fsodari/USBAudioBridge/README.md

# USB Audio Bridge

KiCAD Project for a USB Audio Bridge based on an NXP RT1010

## Requirements

- NXP RT1010
- High Speed USB C connector
- MCU Link compatible SWD header
- 2 PMOD pin headers designed to mate with an Arty A7 development board
    - Route 2 I2S busses through one PMOD. One for input, one for output
    - Route SPI and GPIO through the second PMOD.
- Should be designed for a USB asynchronous audio class device.
- Should use a stable, accurate, 24.576Mhz oscillator for the Audio master clock

## KiCAD Project Requirements
- All erc/drc should pass
- Include 3D models for all parts
- Set up pipelines to generate design files that can be delivered to a PCBA manufacturer

## Using this repository

- `hardware/`: KiCad 10 project (revision v1.0). The schematic is generated from `tools/design.py`; edit that, not the `.kicad_sch` files.
- `docs/reference-manual.md`: developer reference for the RT1010 firmware and the Arty A7 FPGA design (pin map, clocks, boot, I2S/USB/SPI, XDC constraints, errata).
- Fabrication outputs for JLCPCB and PCBWay (Gerbers, drill, BOM, pick-and-place, assembly drawings, schematic PDF):
  - locally: `python3 tools/fab.py` (needs KiCad 10), output in `hardware/build/fab/`
  - on GitHub: the "Fabrication outputs" workflow runs on every push to `main` and uploads both packages as artifacts; pushing a `v*` tag attaches them to a release.
