fsodari/USBAudioBridge/hardware/USBAudioBridge.kicad_pcb

## KiCad design hardware/USBAudioBridge.kicad_pcb (2026-10-24)

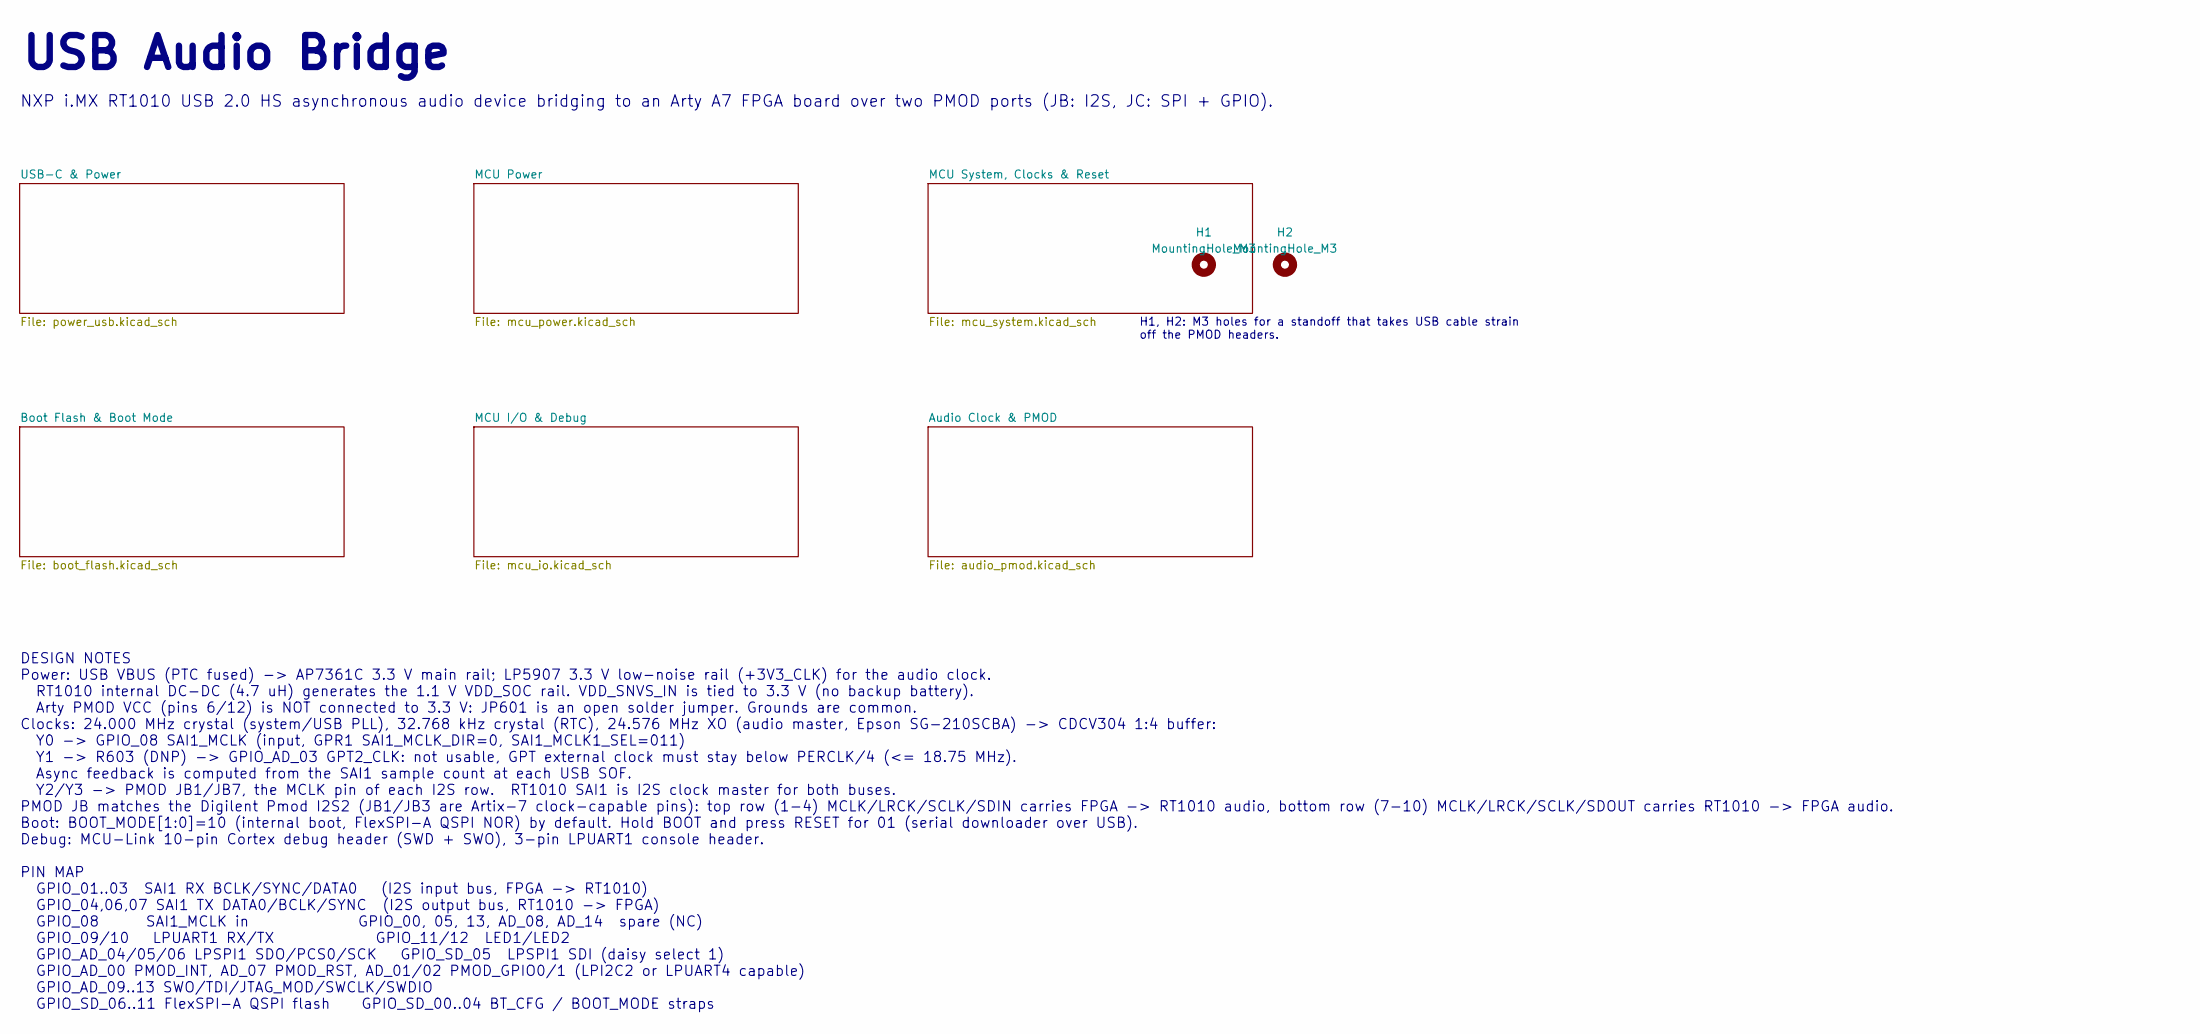
[picture p1: schematic USBAudioBridge.kicad_sch, USB Audio Bridge]

Parts:
H1, H2: MountingHole_M3; MountingHole_3.2mm_M3

Notes on the sheet:
USB Audio Bridge
DESIGN NOTES Power: USB VBUS (PTC fused) -> AP7361C 3.3 V main rail; LP5907 3.3 V low-noise rail (+3V3_CLK) for the audio clock. RT1010 internal DC-DC (4.7 uH) generates the 1.1 V VDD_SOC rail. VDD_SNVS_IN is tied to 3.3 V (no backup battery). Arty PMOD VCC (pins 6/12) is NOT connected to 3.3 V: JP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
H1, H2: M3 holes for a standoff that takes USB cable strain off the PMOD headers.
NXP i.MX RT1010 USB 2.0 HS asynchronous audio device bridging to an Arty A7 FPGA board over two PMOD ports (JB: I2S, JC: SPI + GPIO).

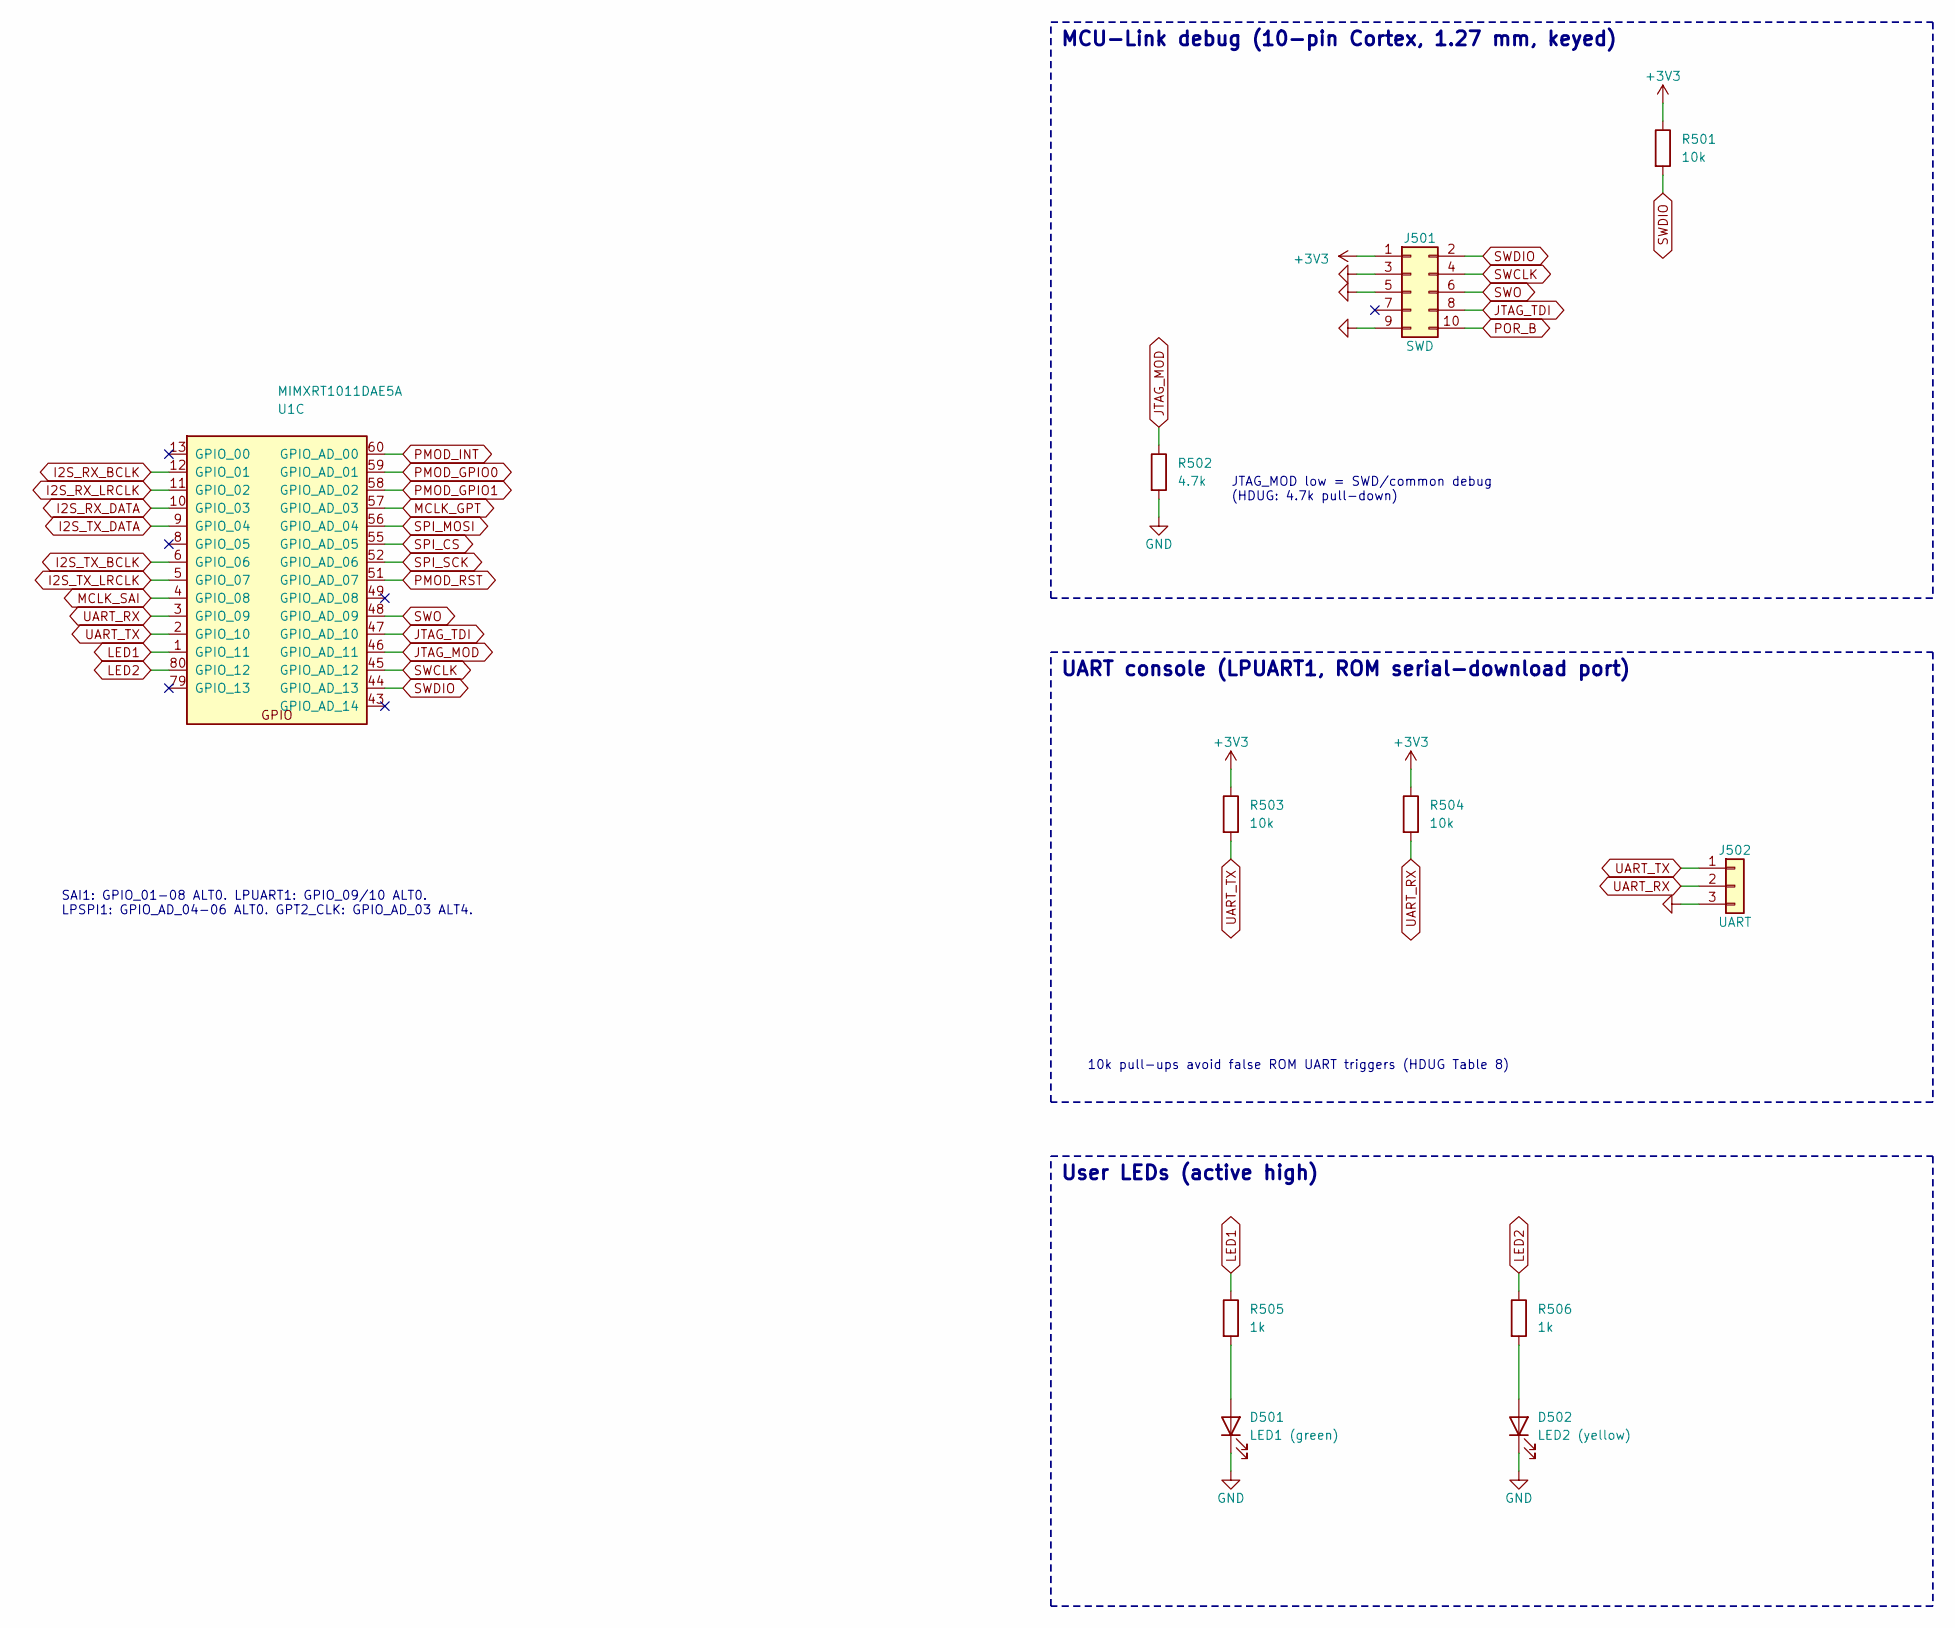
[picture p2: schematic mcu_io.kicad_sch, USB Audio Bridge]

Parts:
D501: LED1 (green); LED_0603_1608Metric; MPN KT-0603YG; LCSC C2289
D502: LED2 (yellow); LED_0603_1608Metric; MPN KT-0603Y; LCSC C2287
J501: SWD; Samtec_FTSH-105-01-L-DV-K; MPN FTSH-105-01-L-DV-K; LCSC C5155080
J502: UART; PinHeader_1x03_P2.54mm_Vertical; MPN PZ254V-11-03P; LCSC C2937625
R501, R503, R504: 10k; R_0402_1005Metric; MPN 0402WGF1002TCE; LCSC C25744
R502: 4.7k; R_0402_1005Metric; MPN 0402WGF4701TCE; LCSC C25900
R505, R506: 1k; R_0402_1005Metric; MPN 0402WGF1001TCE; LCSC C11702
U1: MIMXRT1011DAE5A; LQFP-80_12x12mm_P0.5mm; MPN MIMXRT1011DAE5A; LCSC C1575810

Connections:
+3V3: J501.1, R501.1, R503.1, R504.1; also elsewhere on the board
GND: D501.1 (K), D502.1 (K), J501.3, J501.5, J501.9, J502.3, R502.2; also elsewhere on the board
I2S_RX_BCLK: U1.12 (GPIO_01); also elsewhere on the board
I2S_RX_DATA: U1.10 (GPIO_03); also elsewhere on the board
I2S_RX_LRCLK: U1.11 (GPIO_02); also elsewhere on the board
I2S_TX_BCLK: U1.6 (GPIO_06); also elsewhere on the board
I2S_TX_DATA: U1.9 (GPIO_04); also elsewhere on the board
I2S_TX_LRCLK: U1.5 (GPIO_07); also elsewhere on the board
JTAG_MOD: R502.1, U1.46 (GPIO_AD_11)
JTAG_TDI: J501.8, U1.47 (GPIO_AD_10)
LED1: R505.1, U1.1 (GPIO_11)
LED2: R506.1, U1.80 (GPIO_12)
MCLK_GPT: U1.57 (GPIO_AD_03); also elsewhere on the board
MCLK_SAI: U1.4 (GPIO_08); also elsewhere on the board
unnamed: D501.2 (A), R505.2
unnamed: D502.2 (A), R506.2
PMOD_GPIO0: U1.59 (GPIO_AD_01); also elsewhere on the board
PMOD_GPIO1: U1.58 (GPIO_AD_02); also elsewhere on the board
PMOD_INT: U1.60 (GPIO_AD_00); also elsewhere on the board
PMOD_RST: U1.51 (GPIO_AD_07); also elsewhere on the board
POR_B: J501.10; also elsewhere on the board
SPI_CS: U1.55 (GPIO_AD_05); also elsewhere on the board
SPI_MOSI: U1.56 (GPIO_AD_04); also elsewhere on the board
SPI_SCK: U1.52 (GPIO_AD_06); also elsewhere on the board
SWCLK: J501.4, U1.45 (GPIO_AD_12)
SWDIO: J501.2, R501.2, U1.44 (GPIO_AD_13)
SWO: J501.6, U1.48 (GPIO_AD_09)
UART_RX: J502.2, R504.2, U1.3 (GPIO_09)
UART_TX: J502.1, R503.2, U1.2 (GPIO_10)

Notes on the sheet:
10k pull-ups avoid false ROM UART triggers (HDUG Table 8)
UART console (LPUART1, ROM serial-download port)
User LEDs (active high)
SAI1: GPIO_01-08 ALT0. LPUART1: GPIO_09/10 ALT0. LPSPI1: GPIO_AD_04-06 ALT0. GPT2_CLK: GPIO_AD_03 ALT4.
MCU-Link debug (10-pin Cortex, 1.27 mm, keyed)
JTAG_MOD low = SWD/common debug (HDUG: 4.7k pull-down)

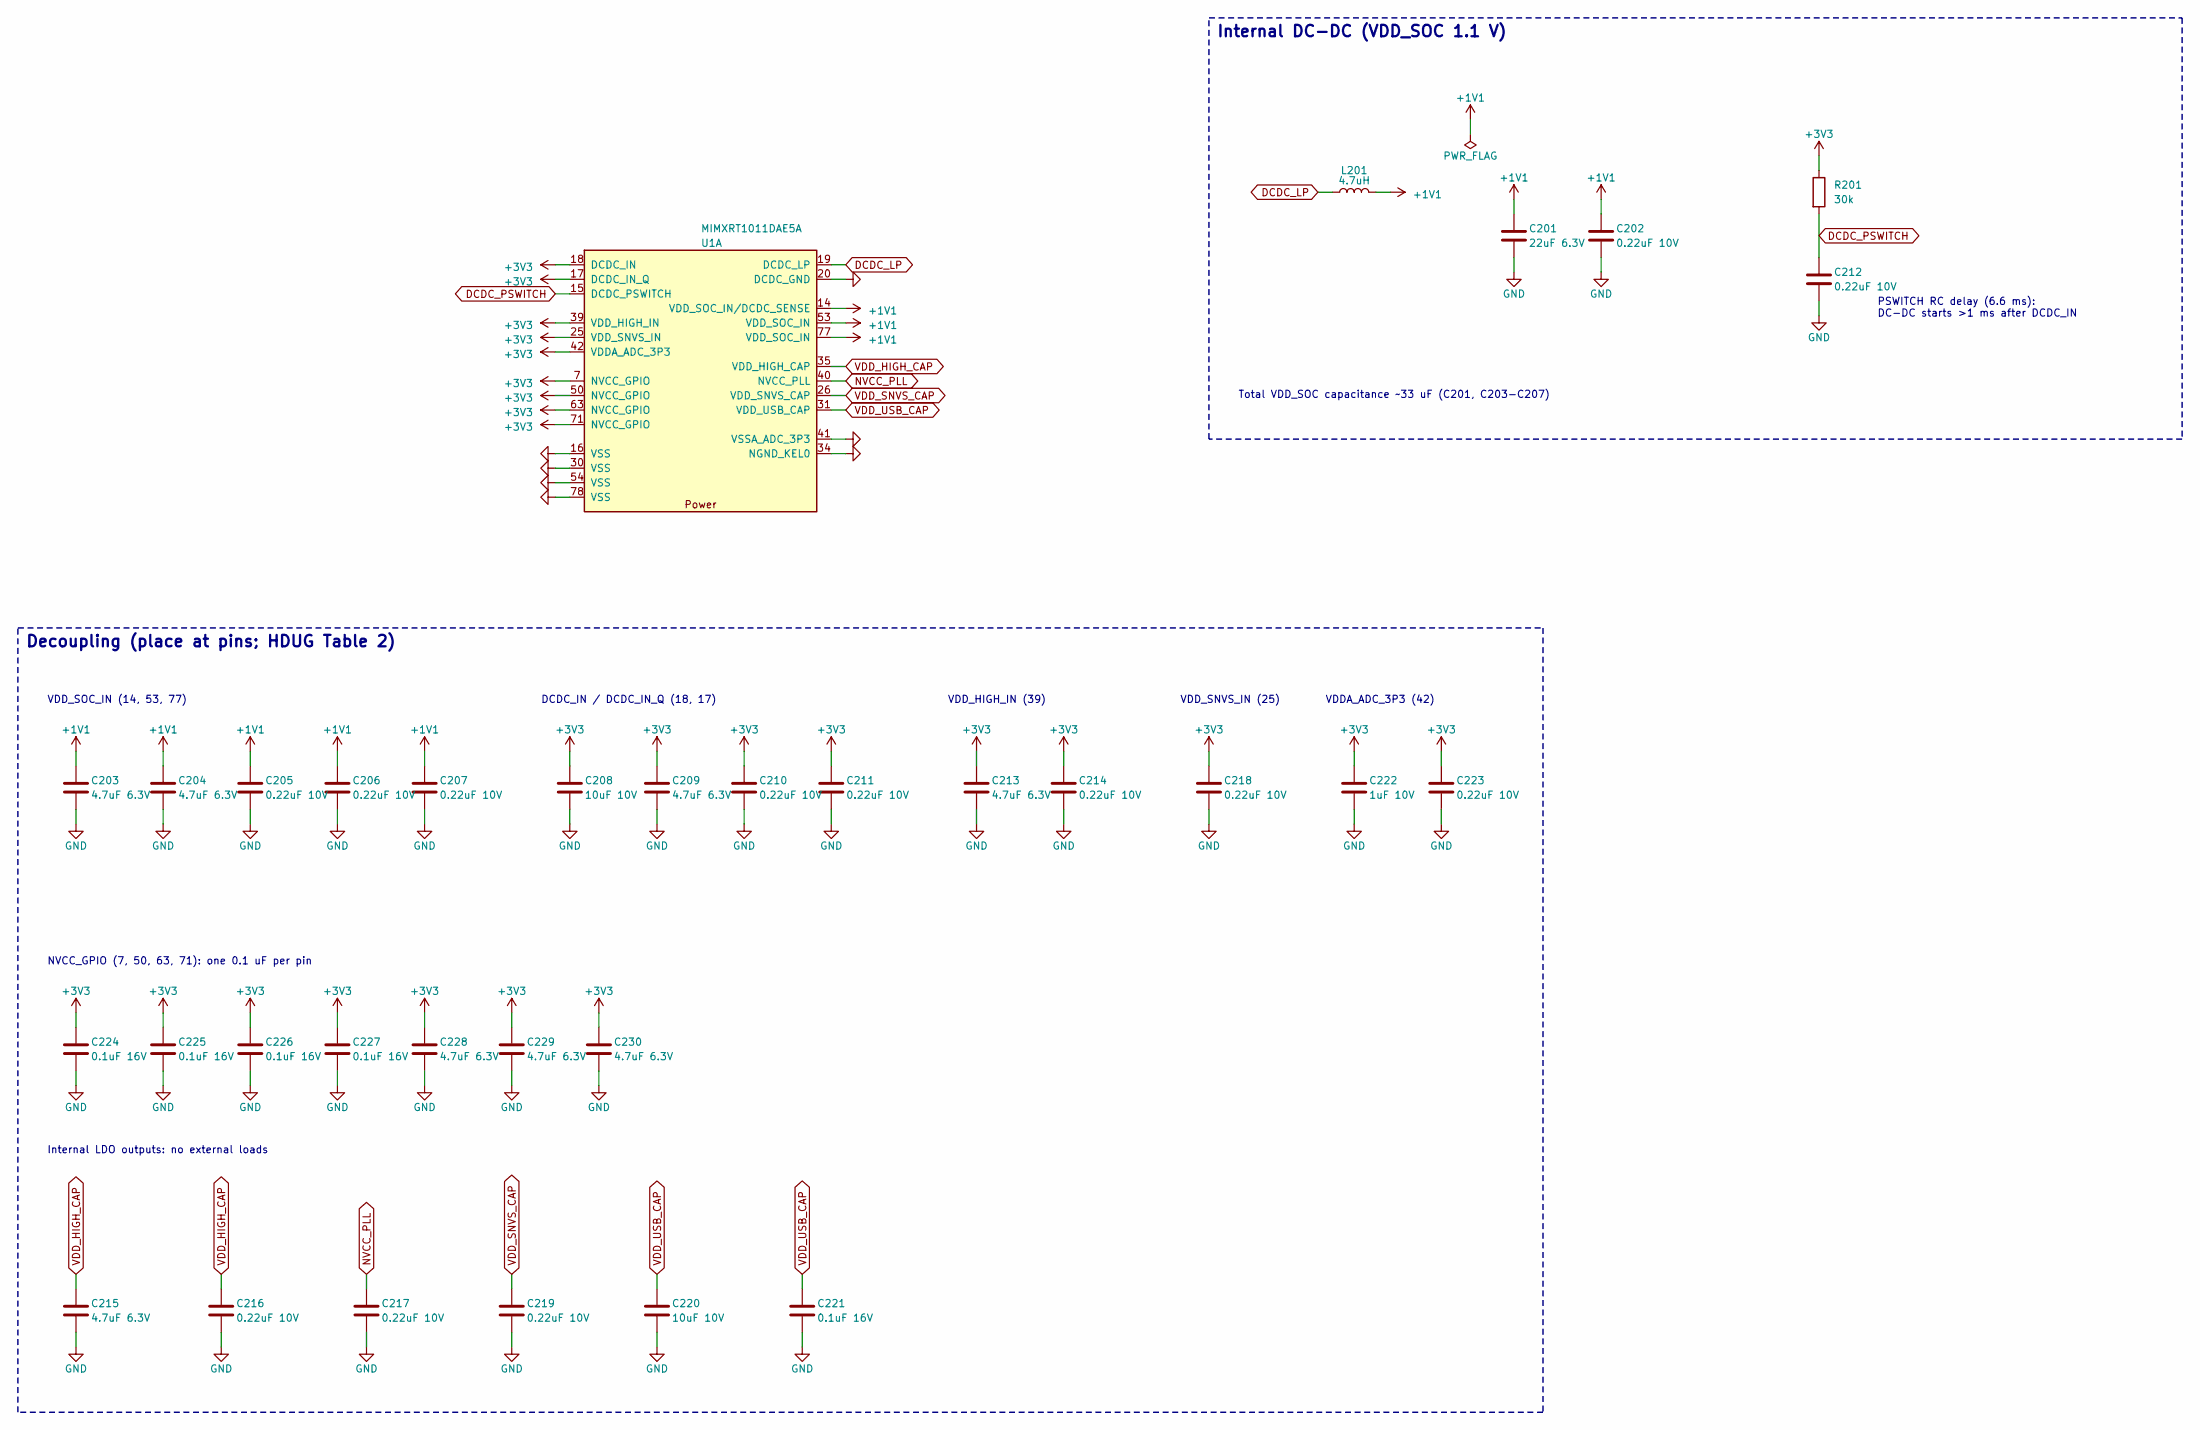
[picture p3: schematic mcu_power.kicad_sch, USB Audio Bridge]

Parts:
C201: 22uF 6.3V; C_0805_2012Metric; MPN CL21A226MAQNNNE; LCSC C45783
C202, C205, C206, C207, C210, C211, C212, C214, C216, C217, C218, C219, C223: 0.22uF 10V; C_0402_1005Metric; MPN CL05B224KO5NNNC; LCSC C16772
C203, C204, C209, C213, C215, C228, C229, C230: 4.7uF 6.3V; C_0402_1005Metric; MPN CL05A475MP5NRNC; LCSC C23733
C208, C220: 10uF 10V; C_0603_1608Metric; MPN CL10A106KP8NNNC; LCSC C19702
C221, C224, C225, C226, C227: 0.1uF 16V; C_0402_1005Metric; MPN CL05B104KO5NNNC; LCSC C1525
C222: 1uF 10V; C_0402_1005Metric; MPN CL05A105KA5NQNC; LCSC C52923
L201: 4.7uH; L_Bourns-SRN4018; MPN SRN4018-4R7M; LCSC C780206
R201: 30k; R_0402_1005Metric; MPN 0402WGF3002TCE; LCSC C25776
U1: MIMXRT1011DAE5A; LQFP-80_12x12mm_P0.5mm; MPN MIMXRT1011DAE5A; LCSC C1575810

Connections:
+1V1: C201.1, C202.1, C203.1, C204.1, C205.1, C206.1, C207.1, L201.2, U1.14 (VDD_SOC_IN/DCDC_SENSE), U1.53 (VDD_SOC_IN), U1.77 (VDD_SOC_IN)
+3V3: C208.1, C209.1, C210.1, C211.1, C213.1, C214.1, C218.1, C222.1, C223.1, C224.1, C225.1, C226.1, C227.1, C228.1, C229.1, C230.1, R201.1, U1.7 (NVCC_GPIO), U1.17 (DCDC_IN_Q), U1.18 (DCDC_IN), U1.25 (VDD_SNVS_IN), U1.39 (VDD_HIGH_IN), U1.42 (VDDA_ADC_3P3), U1.50 (NVCC_GPIO), U1.63 (NVCC_GPIO), U1.71 (NVCC_GPIO); also elsewhere on the board
DCDC_LP: L201.1, U1.19 (DCDC_LP)
DCDC_PSWITCH: C212.1, R201.2, U1.15 (DCDC_PSWITCH)
GND: C201.2, C202.2, C203.2, C204.2, C205.2, C206.2, C207.2, C208.2, C209.2, C210.2, C211.2, C212.2, C213.2, C214.2, C215.2, C216.2, C217.2, C218.2, C219.2, C220.2, C221.2, C222.2, C223.2, C224.2, C225.2, C226.2, C227.2, C228.2, C229.2, C230.2, U1.16 (VSS), U1.20 (DCDC_GND), U1.30 (VSS), U1.34 (NGND_KEL0), U1.41 (VSSA_ADC_3P3), U1.54 (VSS), U1.78 (VSS); also elsewhere on the board
NVCC_PLL: C217.1, U1.40 (NVCC_PLL)
VDD_HIGH_CAP: C215.1, C216.1, U1.35 (VDD_HIGH_CAP)
VDD_SNVS_CAP: C219.1, U1.26 (VDD_SNVS_CAP)
VDD_USB_CAP: C220.1, C221.1, U1.31 (VDD_USB_CAP)

Notes on the sheet:
Internal DC-DC (VDD_SOC 1.1 V)
Total VDD_SOC capacitance ~33 uF (C201, C203-C207)
NVCC_GPIO (7, 50, 63, 71): one 0.1 uF per pin
PSWITCH RC delay (6.6 ms): DC-DC starts >1 ms after DCDC_IN
VDD_SNVS_IN (25)
DCDC_IN / DCDC_IN_Q (18, 17)
VDD_SOC_IN (14, 53, 77)
VDD_HIGH_IN (39)
Internal LDO outputs: no external loads
Decoupling (place at pins; HDUG Table 2)
VDDA_ADC_3P3 (42)

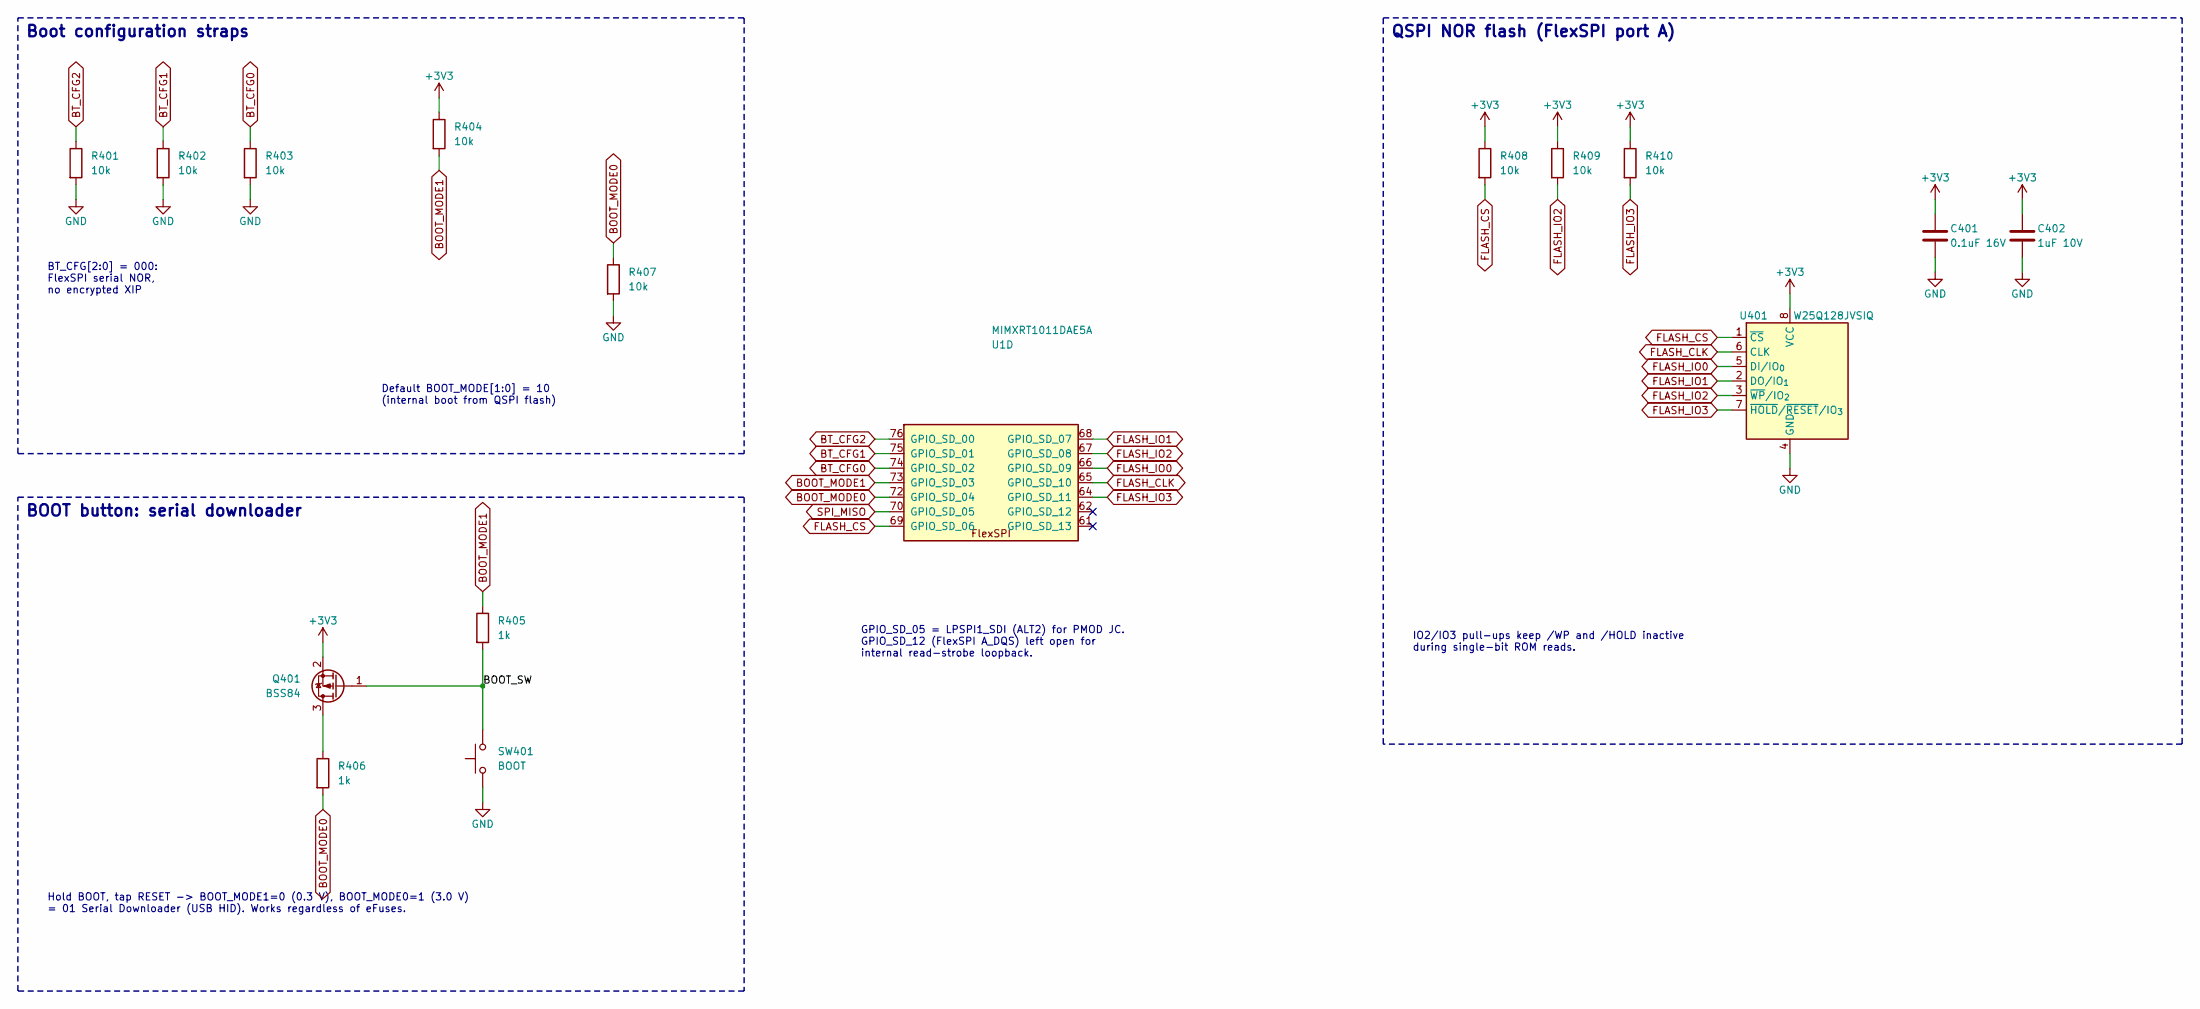
[picture p4: schematic boot_flash.kicad_sch, USB Audio Bridge]

Parts:
C401: 0.1uF 16V; C_0402_1005Metric; MPN CL05B104KO5NNNC; LCSC C1525
C402: 1uF 10V; C_0402_1005Metric; MPN CL05A105KA5NQNC; LCSC C52923
Q401: BSS84; SOT-23; MPN BSS84LT1G; LCSC C82079
R401, R402, R403, R404, R407, R408, R409, R410: 10k; R_0402_1005Metric; MPN 0402WGF1002TCE; LCSC C25744
R405, R406: 1k; R_0402_1005Metric; MPN 0402WGF1001TCE; LCSC C11702
SW401: BOOT; SW_SPST_PTS810; MPN PTS810SJG250SMTRLFS; LCSC C221895
U1: MIMXRT1011DAE5A; LQFP-80_12x12mm_P0.5mm; MPN MIMXRT1011DAE5A; LCSC C1575810
U401: W25Q128JVSIQ; SOIC-8_5.3x5.3mm_P1.27mm; MPN W25Q128JVSIQ; LCSC C97521

Connections:
+3V3: C401.1, C402.1, Q401.2 (S), R404.1, R408.1, R409.1, R410.1, U401.8 (VCC); also elsewhere on the board
/Boot Flash & Boot Mode/BOOT_SW: Q401.1 (G), R405.2, SW401.2
BOOT_MODE0: R406.2, R407.1, U1.72 (GPIO_SD_04)
BOOT_MODE1: R404.2, R405.1, U1.73 (GPIO_SD_03)
BT_CFG0: R403.1, U1.74 (GPIO_SD_02)
BT_CFG1: R402.1, U1.75 (GPIO_SD_01)
BT_CFG2: R401.1, U1.76 (GPIO_SD_00)
FLASH_CLK: U1.65 (GPIO_SD_10), U401.6 (CLK)
FLASH_CS: R408.2, U1.69 (GPIO_SD_06), U401.1 (~CS)
FLASH_IO0: U1.66 (GPIO_SD_09), U401.5 (DI/IO_{0})
FLASH_IO1: U1.68 (GPIO_SD_07), U401.2 (DO/IO_{1})
FLASH_IO2: R409.2, U1.67 (GPIO_SD_08), U401.3 (~WP/IO_{2})
FLASH_IO3: R410.2, U1.64 (GPIO_SD_11), U401.7 (~HOLD/~RESET/IO_{3})
GND: C401.2, C402.2, R401.2, R402.2, R403.2, R407.2, SW401.1, U401.4 (GND); also elsewhere on the board
unnamed: Q401.3 (D), R406.1
SPI_MISO: U1.70 (GPIO_SD_05); also elsewhere on the board

Notes on the sheet:
BT_CFG[2:0] = 000: FlexSPI serial NOR, no encrypted XIP
GPIO_SD_05 = LPSPI1_SDI (ALT2) for PMOD JC. GPIO_SD_12 (FlexSPI A_DQS) left open for internal read-strobe loopback.
QSPI NOR flash (FlexSPI port A)
Boot configuration straps
Default BOOT_MODE[1:0] = 10 (internal boot from QSPI flash)
BOOT button: serial downloader
IO2/IO3 pull-ups keep /WP and /HOLD inactive during single-bit ROM reads.
Hold BOOT, tap RESET -> BOOT_MODE1=0 (0.3 V), BOOT_MODE0=1 (3.0 V) = 01 Serial Downloader (USB HID). Works regardless of eFuses.

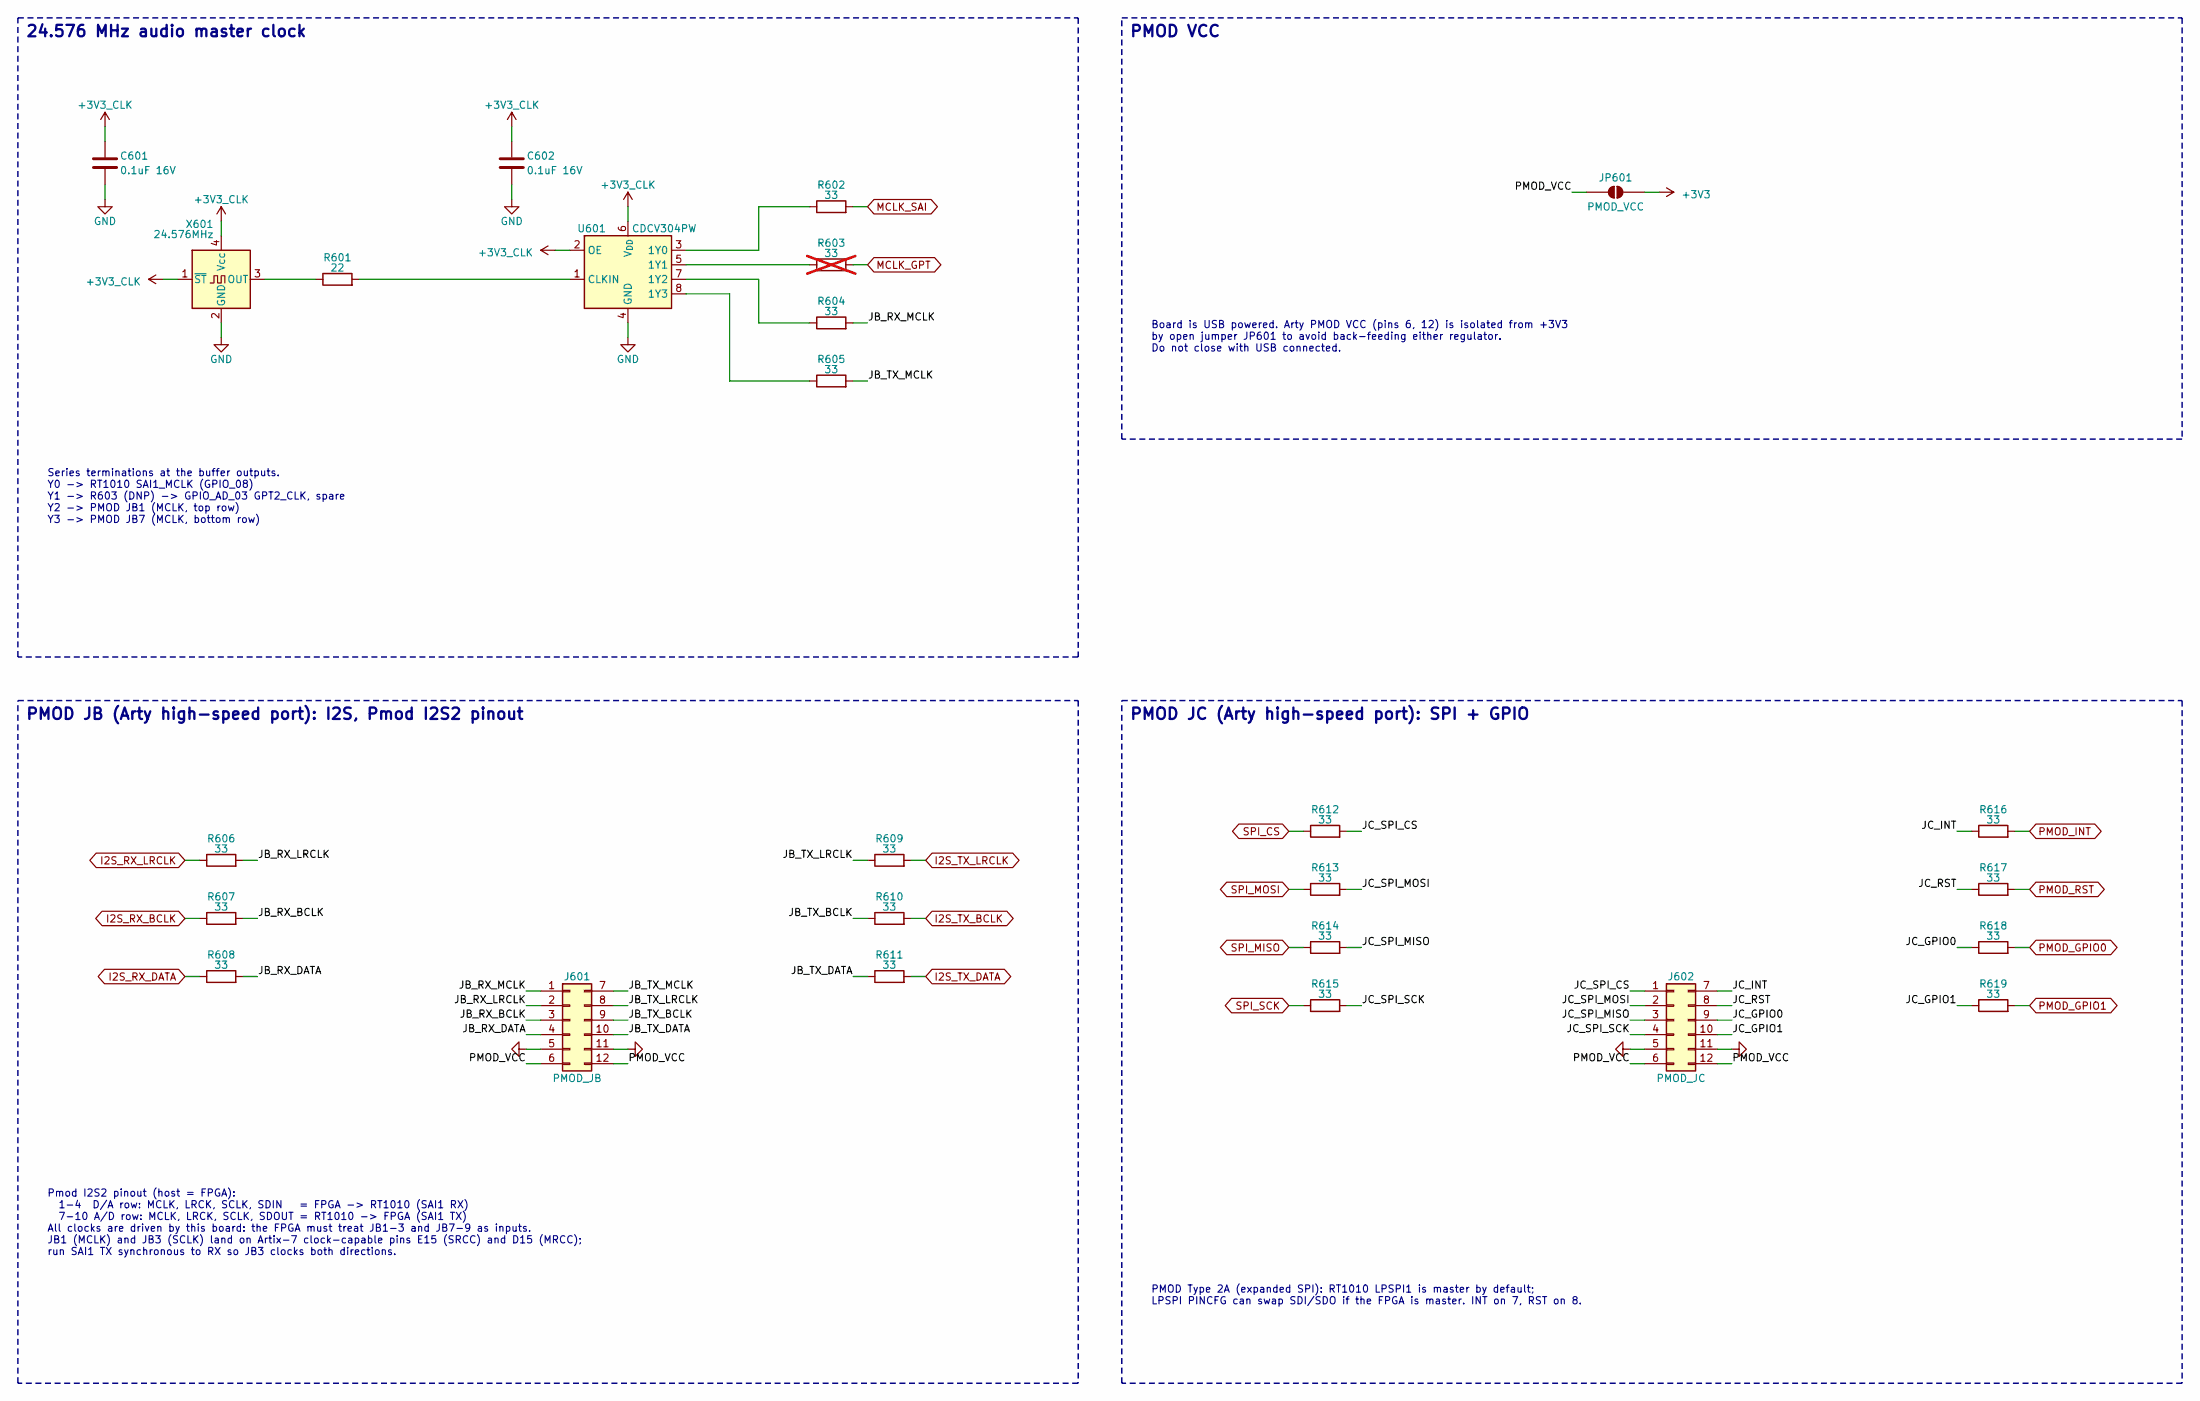
[picture p5: schematic audio_pmod.kicad_sch, USB Audio Bridge]

Parts:
C601, C602: 0.1uF 16V; C_0402_1005Metric; MPN CL05B104KO5NNNC; LCSC C1525
J601: PMOD_JB; PMOD_Peripheral_2x06_P2.54mm_Horizontal; MPN PZ254R-12-12P; LCSC C492434
J602: PMOD_JC; PMOD_Peripheral_2x06_P2.54mm_Horizontal; MPN PZ254R-12-12P; LCSC C492434
JP601: PMOD_VCC; SolderJumper-2_P1.3mm_Open_RoundedPad1.0x1.5mm
R601: 22; R_0402_1005Metric; MPN 0402WGF220JTCE; LCSC C25092
R602, R604, R605, R606, R607, R608, R609, R610, R611, R612, R613, R614, R615, R616, R617, R618, R619: 33; R_0402_1005Metric; MPN 0402WGF330JTCE; LCSC C25105
R603: 33; R_0402_1005Metric; MPN 0402WGF330JTCE; LCSC C25105; not fitted
U601: CDCV304PW; TSSOP-8_4.4x3mm_P0.65mm; MPN CDCV304PWR; LCSC C105237
X601: 24.576MHz; Oscillator_SMD_SeikoEpson_SG210-4Pin_2.5x2.0mm; MPN X1G004591A052; LCSC C5154204

Connections:
+3V3: JP601.2 (B); also elsewhere on the board
+3V3_CLK: C601.1, C602.1, U601.2 (OE), U601.6 (V_{DD}), X601.1 (~ST), X601.4 (Vcc); also elsewhere on the board
/Audio Clock & PMOD/JB_RX_BCLK: J601.3, R607.2
/Audio Clock & PMOD/JB_RX_DATA: J601.4, R608.2
/Audio Clock & PMOD/JB_RX_LRCLK: J601.2, R606.2
/Audio Clock & PMOD/JB_RX_MCLK: J601.1, R604.2
/Audio Clock & PMOD/JB_TX_BCLK: J601.9, R610.1
/Audio Clock & PMOD/JB_TX_DATA: J601.10, R611.1
/Audio Clock & PMOD/JB_TX_LRCLK: J601.8, R609.1
/Audio Clock & PMOD/JB_TX_MCLK: J601.7, R605.2
/Audio Clock & PMOD/JC_GPIO0: J602.9, R618.1
/Audio Clock & PMOD/JC_GPIO1: J602.10, R619.1
/Audio Clock & PMOD/JC_INT: J602.7, R616.1
/Audio Clock & PMOD/JC_RST: J602.8, R617.1
/Audio Clock & PMOD/JC_SPI_CS: J602.1, R612.2
/Audio Clock & PMOD/JC_SPI_MISO: J602.3, R614.2
/Audio Clock & PMOD/JC_SPI_MOSI: J602.2, R613.2
/Audio Clock & PMOD/JC_SPI_SCK: J602.4, R615.2
/Audio Clock & PMOD/PMOD_VCC: J601.6, J601.12, J602.6, J602.12, JP601.1 (A)
GND: C601.2, C602.2, J601.5, J601.11, J602.5, J602.11, U601.4 (GND), X601.2 (GND); also elsewhere on the board
I2S_RX_BCLK: R607.1; also elsewhere on the board
I2S_RX_DATA: R608.1; also elsewhere on the board
I2S_RX_LRCLK: R606.1; also elsewhere on the board
I2S_TX_BCLK: R610.2; also elsewhere on the board
I2S_TX_DATA: R611.2; also elsewhere on the board
I2S_TX_LRCLK: R609.2; also elsewhere on the board
MCLK_GPT: R603.2; also elsewhere on the board
MCLK_SAI: R602.2; also elsewhere on the board
unnamed: R602.1, U601.3 (1Y0)
unnamed: R603.1, U601.5 (1Y1)
unnamed: R604.1, U601.7 (1Y2)
unnamed: R605.1, U601.8 (1Y3)
unnamed: R601.2, U601.1 (CLKIN)
unnamed: R601.1, X601.3 (OUT)
PMOD_GPIO0: R618.2; also elsewhere on the board
PMOD_GPIO1: R619.2; also elsewhere on the board
PMOD_INT: R616.2; also elsewhere on the board
PMOD_RST: R617.2; also elsewhere on the board
SPI_CS: R612.1; also elsewhere on the board
SPI_MISO: R614.1; also elsewhere on the board
SPI_MOSI: R613.1; also elsewhere on the board
SPI_SCK: R615.1; also elsewhere on the board

Notes on the sheet:
24.576 MHz audio master clock
PMOD JC (Arty high-speed port): SPI + GPIO
PMOD JB (Arty high-speed port): I2S, Pmod I2S2 pinout
Board is USB powered. Arty PMOD VCC (pins 6, 12) is isolated from +3V3 by open jumper JP601 to avoid back-feeding either regulator. Do not close with USB connected.
Pmod I2S2 pinout (host = FPGA): 1-4 D/A row: MCLK, LRCK, SCLK, SDIN = FPGA -> RT1010 (SAI1 RX) 7-10 A/D row: MCLK, LRCK, SCLK, SDOUT = RT1010 -> FPGA (SAI1 TX) All clocks are driven by this board: the FPGA must treat JB1-3 and JB7-9 as inputs. JB1 (MCLK) and JB3 (SCLK) land on Artix-7 clock-capable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
PMOD Type 2A (expanded SPI): RT1010 LPSPI1 is master by default; LPSPI PINCFG can swap SDI/SDO if the FPGA is master. INT on 7, RST on 8.
Series terminations at the buffer outputs. Y0 -> RT1010 SAI1_MCLK (GPIO_08) Y1 -> R603 (DNP) -> GPIO_AD_03 GPT2_CLK, spare Y2 -> PMOD JB1 (MCLK, top row) Y3 -> PMOD JB7 (MCLK, bottom row)
PMOD VCC
