fsodari/USBAudioBridge/hardware/USBAudioBridge.kicad_pcb

## KiCad design hardware/USBAudioBridge.kicad_pcb (continued)

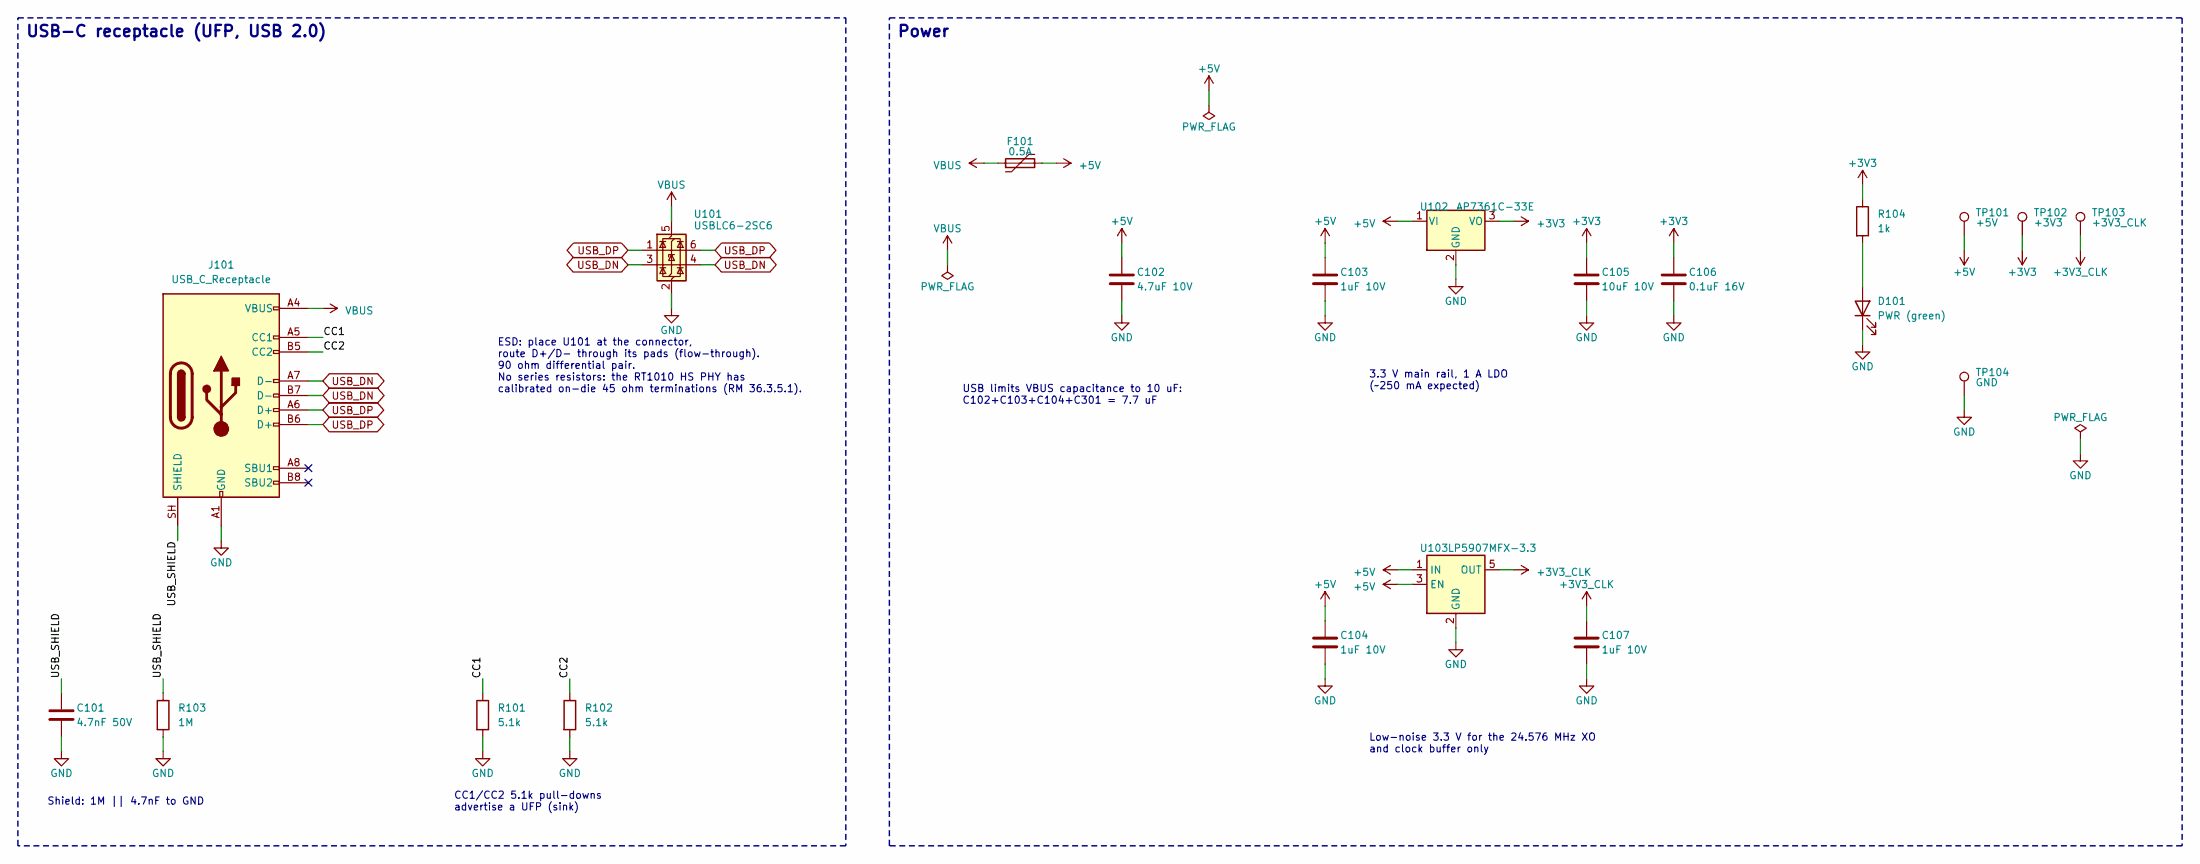
[picture p6: schematic power_usb.kicad_sch, USB Audio Bridge]

Parts:
C101: 4.7nF 50V; C_0402_1005Metric; MPN 0402B472K500NT; LCSC C1538
C102: 4.7uF 10V; C_0603_1608Metric; MPN CL10A475KO8NNNC; LCSC C19666
C103, C104, C107: 1uF 10V; C_0603_1608Metric; MPN CL10A105KB8NNNC; LCSC C15849
C105: 10uF 10V; C_0603_1608Metric; MPN CL10A106KP8NNNC; LCSC C19702
C106: 0.1uF 16V; C_0402_1005Metric; MPN CL05B104KO5NNNC; LCSC C1525
D101: PWR (green); LED_0603_1608Metric; MPN KT-0603YG; LCSC C2289
F101: 0.5A; Fuse_1206_3216Metric; MPN SMD1206P050TF/13.2; LCSC C43379
J101: USB_C_Receptacle; USB_C_Receptacle_GCT_USB4105-xx-A_16P_TopMnt_Horizontal; MPN USB4105-GF-A-120; LCSC C5184243
R101, R102: 5.1k; R_0402_1005Metric; MPN 0402WGF5101TCE; LCSC C25905
R103: 1M; R_0402_1005Metric; MPN 0402WGF1004TCE; LCSC C26083
R104: 1k; R_0402_1005Metric; MPN 0402WGF1001TCE; LCSC C11702
TP101: +5V; TestPoint_Pad_D1.0mm
TP102: +3V3; TestPoint_Pad_D1.0mm
TP103: +3V3_CLK; TestPoint_Pad_D1.0mm
TP104: GND; TestPoint_Pad_D1.0mm
U101: USBLC6-2SC6; SOT-23-6; MPN USBLC6-2SC6; LCSC C7519
U102: AP7361C-33E; SOT-223-3_TabPin2; MPN AP7361C-33E-13; LCSC C500795
U103: LP5907MFX-3.3; SOT-23-5; MPN LP5907MFX-3.3/NOPB; LCSC C80670

Connections:
+3V3: C105.1, C106.1, R104.1, TP102.1, U102.3 (VO); also elsewhere on the board
+3V3_CLK: C107.1, TP103.1, U103.5 (OUT); also elsewhere on the board
+5V: C102.1, C103.1, C104.1, F101.2, TP101.1, U102.1 (VI), U103.1 (IN), U103.3 (EN); also elsewhere on the board
/USB-C & Power/CC1: J101.A5 (CC1), R101.1
/USB-C & Power/CC2: J101.B5 (CC2), R102.1
/USB-C & Power/USB_SHIELD: C101.1, J101.SH (SHIELD), R103.1
GND: C101.2, C102.2, C103.2, C104.2, C105.2, C106.2, C107.2, D101.1 (K), J101.A1 (GND), J101.A12 (GND), J101.B1 (GND), J101.B12 (GND), R101.2, R102.2, R103.2, TP104.1, U101.2 (GND), U102.2 (GND), U103.2 (GND); also elsewhere on the board
unnamed: D101.2 (A), R104.2
USB_DN: J101.A7 (D-), J101.B7 (D-), U101.3 (I/O2), U101.4 (I/O2); also elsewhere on the board
USB_DP: J101.A6 (D+), J101.B6 (D+), U101.1 (I/O1), U101.6 (I/O1); also elsewhere on the board
VBUS: F101.1, J101.A4 (VBUS), J101.A9 (VBUS), J101.B4 (VBUS), J101.B9 (VBUS), U101.5 (VBUS)

Notes on the sheet:
Low-noise 3.3 V for the 24.576 MHz XO and clock buffer only
CC1/CC2 5.1k pull-downs advertise a UFP (sink)
USB-C receptacle (UFP, USB 2.0)
Power
Shield: 1M || 4.7nF to GND
3.3 V main rail, 1 A LDO (~250 mA expected)
USB limits VBUS capacitance to 10 uF: C102+C103+C104+C301 = 7.7 uF
ESD: place U101 at the connector, route D+/D- through its pads (flow-through). 90 ohm differential pair. No series resistors: the RT1010 HS PHY has calibrated on-die 45 ohm terminations (RM 36.3.5.1).

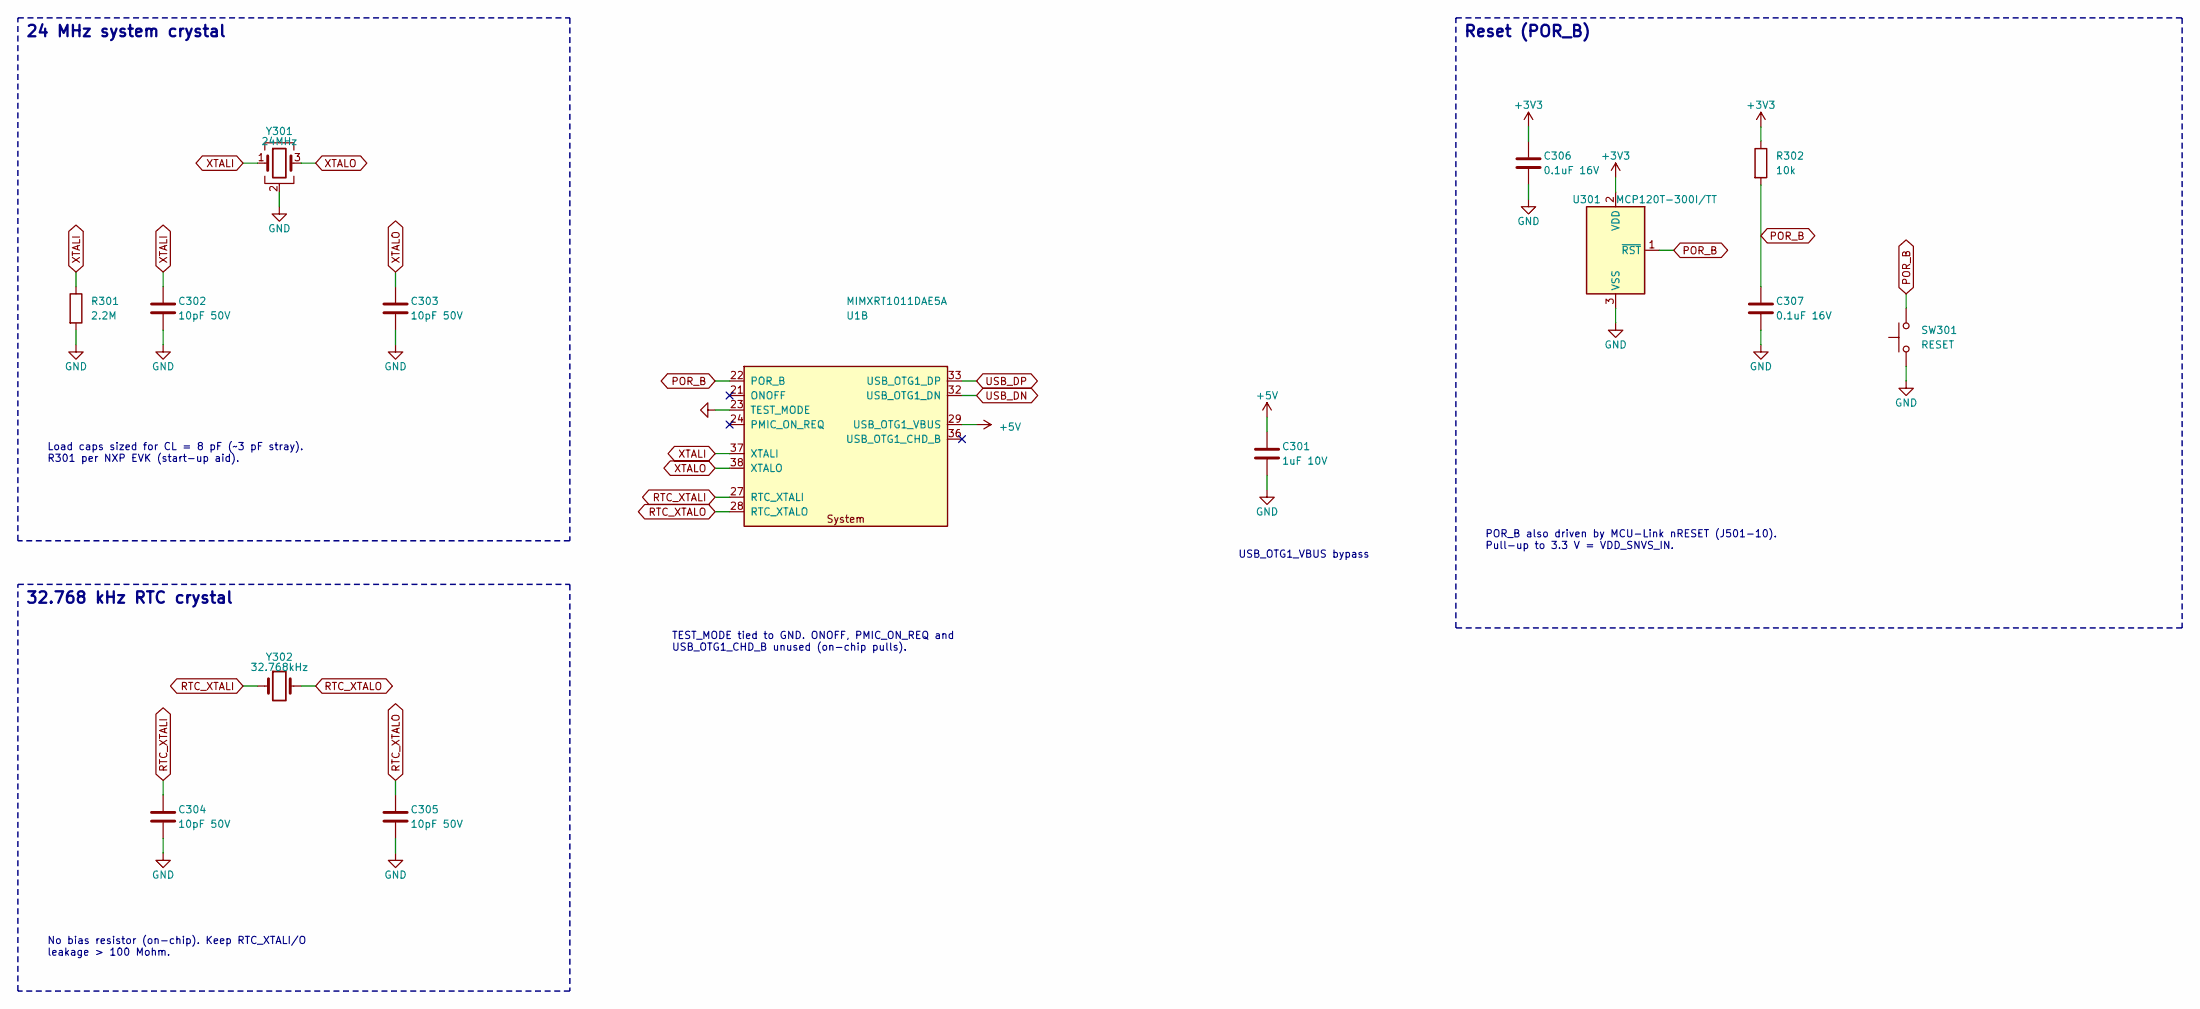
[picture p7: schematic mcu_system.kicad_sch, USB Audio Bridge]

Parts:
C301: 1uF 10V; C_0603_1608Metric; MPN CL10A105KB8NNNC; LCSC C15849
C302, C303, C304, C305: 10pF 50V; C_0402_1005Metric; MPN CL05C100JB5NNNC; LCSC C32949
C306, C307: 0.1uF 16V; C_0402_1005Metric; MPN CL05B104KO5NNNC; LCSC C1525
R301: 2.2M; R_0402_1005Metric; MPN 0402WGF2204TCE; LCSC C11490
R302: 10k; R_0402_1005Metric; MPN 0402WGF1002TCE; LCSC C25744
SW301: RESET; SW_SPST_PTS810; MPN PTS810SJG250SMTRLFS; LCSC C221895
U1: MIMXRT1011DAE5A; LQFP-80_12x12mm_P0.5mm; MPN MIMXRT1011DAE5A; LCSC C1575810
U301: MCP120T-300I/TT; SOT-23; MPN MCP120T-300I/TT; LCSC C625180
Y301: 24MHz; Crystal_SMD_3225-4Pin_3.2x2.5mm; MPN 3225-24-8-10-10/A; LCSC C2981672
Y302: 32.768kHz; Crystal_SMD_3215-2Pin_3.2x1.5mm; MPN Q13FC13500002; LCSC C48615

Connections:
+3V3: C306.1, R302.1, U301.2 (VDD); also elsewhere on the board
+5V: C301.1, U1.29 (USB_OTG1_VBUS); also elsewhere on the board
GND: C301.2, C302.2, C303.2, C304.2, C305.2, C306.2, C307.2, R301.2, SW301.1, U1.23 (TEST_MODE), U301.3 (VSS), Y301.2 (G), Y301.4 (G); also elsewhere on the board
POR_B: C307.1, R302.2, SW301.2, U1.22 (POR_B), U301.1 (~RST); also elsewhere on the board
RTC_XTALI: C304.1, U1.27 (RTC_XTALI), Y302.1
RTC_XTALO: C305.1, U1.28 (RTC_XTALO), Y302.2
USB_DN: U1.32 (USB_OTG1_DN); also elsewhere on the board
USB_DP: U1.33 (USB_OTG1_DP); also elsewhere on the board
XTALI: C302.1, R301.1, U1.37 (XTALI), Y301.1
XTALO: C303.1, U1.38 (XTALO), Y301.3

Notes on the sheet:
POR_B also driven by MCU-Link nRESET (J501-10). Pull-up to 3.3 V = VDD_SNVS_IN.
24 MHz system crystal
TEST_MODE tied to GND. ONOFF, PMIC_ON_REQ and USB_OTG1_CHD_B unused (on-chip pulls).
USB_OTG1_VBUS bypass
32.768 kHz RTC crystal
Reset (POR_B)
No bias resistor (on-chip). Keep RTC_XTALI/O leakage > 100 Mohm.
Load caps sized for CL = 8 pF (~3 pF stray). R301 per NXP EVK (start-up aid).

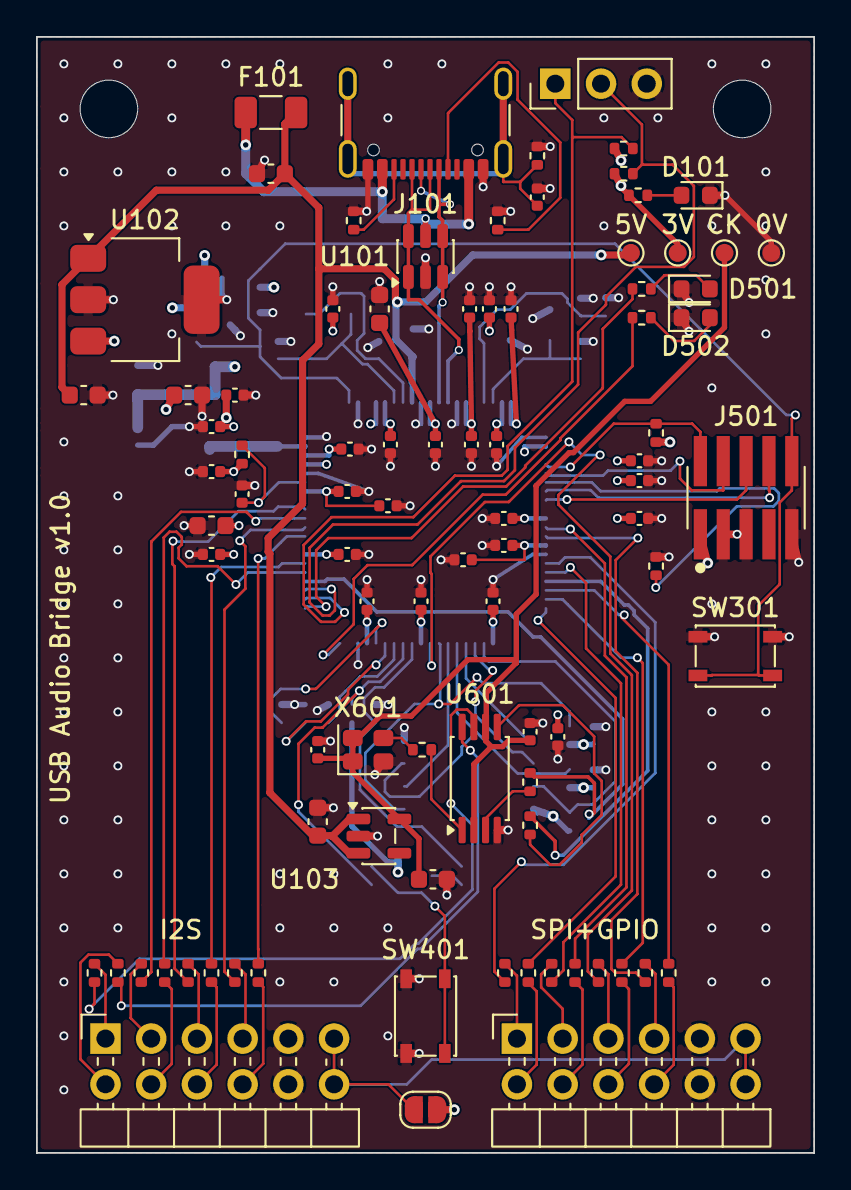
[picture p8: board USBAudioBridge.kicad_pcb from above]

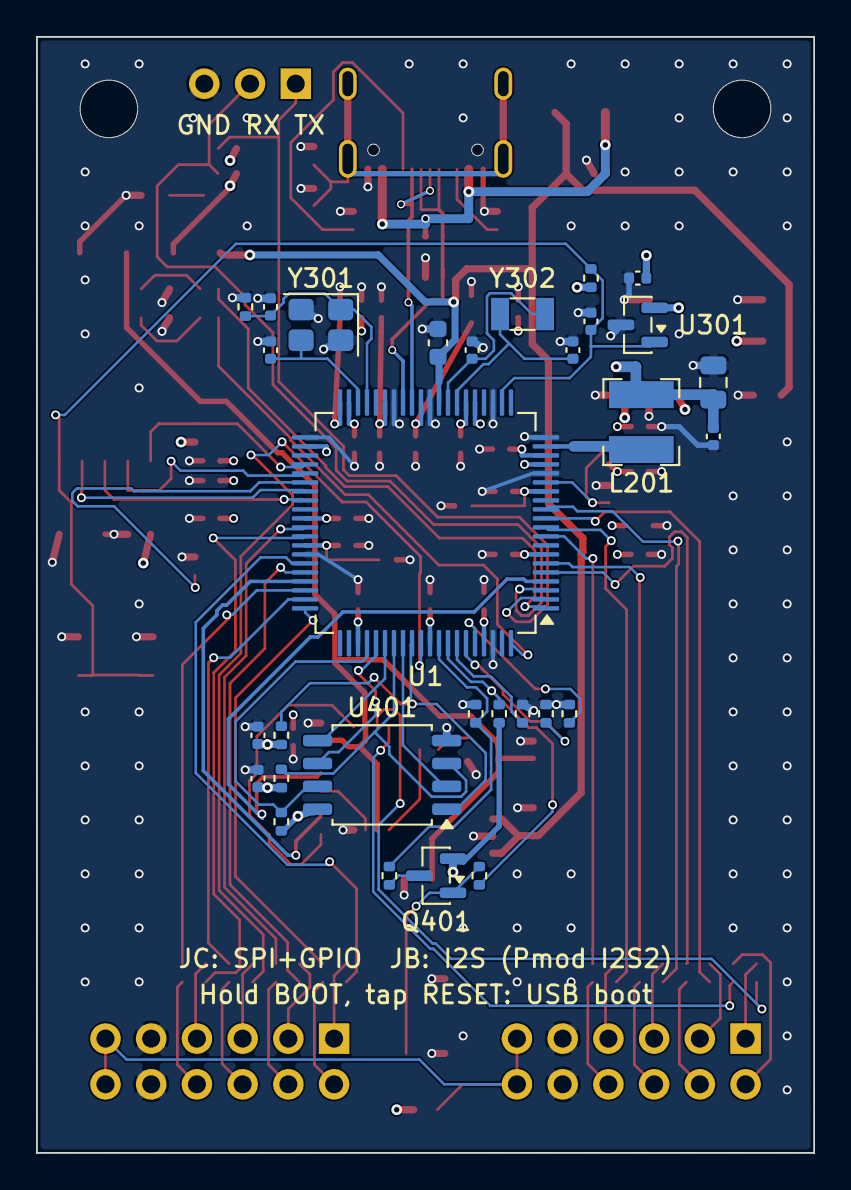
[picture p9: board USBAudioBridge.kicad_pcb from below]

Board: 4 copper layers, 43.2 x 62.0 mm, 120 parts (30 on the bottom side), 86 nets.
