fsodari/USBAudioBridge/(commit log)

2026-10-23 Step 1. Finished initial schematic layout. Pending review
    [USBAudioBridge.kicad_sch, audio_pmod.kicad_sch, boot_flash.kicad_sch, mcu_io.kicad_sch, mcu_power.kicad_sch, mcu_system.kicad_sch, power_usb.kicad_sch]
2026-10-23 Post first draft design review complete
    [USBAudioBridge.kicad_sch, audio_pmod.kicad_sch, boot_flash.kicad_sch, mcu_io.kicad_sch, mcu_power.kicad_sch, mcu_system.kicad_sch, power_usb.kicad_sch]
2026-10-23 finished pcb layout. reviewing
    [USBAudioBridge.kicad_pcb, USBAudioBridge.kicad_sch, audio_pmod.kicad_sch, boot_flash.kicad_sch, mcu_io.kicad_sch, mcu_power.kicad_sch, mcu_system.kicad_sch, power_usb.kicad_sch]
2026-10-24 post pcb layout design review
    [USBAudioBridge.kicad_sch, audio_pmod.kicad_sch, boot_flash.kicad_sch, mcu_io.kicad_sch, mcu_power.kicad_sch, mcu_system.kicad_sch]
2026-10-24 finish second pcb layout revision
    [USBAudioBridge.kicad_pcb, USBAudioBridge.kicad_sch, audio_pmod.kicad_sch, boot_flash.kicad_sch, mcu_io.kicad_sch, mcu_power.kicad_sch, mcu_system.kicad_sch, power_usb.kicad_sch]
2026-10-24 Add fab pipeline, sourcing, CI and developer reference manual
    - tools/fab.py: ERC/DRC gate, then JLCPCB (LCSC BOM, rotation-corrected
    CPL) and PCBWay (MPN BOM, centroid) packages with Gerbers, drill,
    assembly drawings, schematic PDF and order notes
    - .github/workflows/fab.yml: runs fab.py in kicad/kicad:10.0.7; artifacts
    on push/PR, release assets on v* tags
    - design.py: MPN/Manufacturer/LCSC for every BOM line (checked against
    JLCPCB stock); SG-210SCBA oscillator, Liming 200 uW 24 MHz crystal,
    PTS810SJG switches, USB4105-GF-A-120, ~2 V LEDs
    - R603 DNP: GPT2 cannot count 24.576 MHz (external clock < PERCLK/4,
    PERCLK <= 75 MHz); async feedback comes from SAI sample counts
    - Via dr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
    [USBAudioBridge.kicad_pcb, USBAudioBridge.kicad_sch, audio_pmod.kicad_sch, boot_flash.kicad_sch, mcu_io.kicad_sch, mcu_power.kicad_sch, mcu_system.kicad_sch, power_usb.kicad_sch]
2026-10-24 CI: install KiCad's stock library tables for the root user
    Running as root with the runner's HOME, kicad-cli has no global sym/fp
    lib tables, so ERC reported every standard library as missing.
2026-10-24 improve manufacturability
    [USBAudioBridge.kicad_pcb]
